mohtheghost/cardboard-robot-voice-assistant/archive/README.md

# Archived firmware versions

Every prototype `.ino` from the development folder, unchanged except that the WiFi name,
WiFi password and server IP were replaced by placeholders. File names are the original
download names: a `_N` suffix is a browser "download again" copy, **not** a version number.
Order them by the date column. `docs/history.md` tells the story; this is the index.

Status meanings: **milestone** = worth reading, **intermediate** = a step on the way,
**broken** = does not compile or is not code, **duplicate** = identical to another file,
**test** = a hardware test utility.

## First mic + speaker attempts (Feb 20-22)

| Date | File | Rate | JSON | Status | What changed |
|---|---|---|---|---|---|
| 2026-02-20 22:10 | `esp32_full_duplex.ino` | 8 kHz | ArduinoJson | intermediate | Origin of the family (no earlier file). Establishes the send path (register {"id":"esp32"} l133, {"target":"pc","type":"audio"} l352), the ArduinoJson StaticJsonDocument<512> parse of incoming tts chunks (l157-174), and the buffer-then-play TtsPlayback struct (l76-86). |
| 2026-02-20 22:34 | `esp32_dual_i2s_final.ino` | 8 kHz | ArduinoJson | intermediate | vs esp32_full_duplex.ino: splits the single duplex port into i2s_install_microphone() (l91, I2S_NUM_0, MASTER\|RX, use_apll true) and i2s_install_speaker() (l116, I2S_NUM_1, MASTER\|TX, 16-bit, use_apll false) with the 14/12/13 amplifier pins; playTtsAudio drops the pcm32 malloc and <<14 loop and writes tts.buffer as int16 to I2S_SPK_PORT; the mic-pause-during-TTS block in loop() (old l477-482) is removed; comments and banners trimmed. |
| 2026-02-21 03:17 | `esp32_dual_i2s_final_1.ino` | 8 kHz | ArduinoJson | intermediate | vs esp32_dual_i2s_final.ino (65 changed lines): purely diagnostic additions to find out why no TTS was being received: DEBUG_MODE (l27), messagesReceived (l92), first-100-chars dump of each WStype_TEXT (l166-172), parse-error reason (l193-197), explicit 'No type field' / 'Unknown type' branches (l206-220), containsKey checks (l226-237). No audio-path change. |
| 2026-02-21 14:16 | `esp32_simple_clean.ino` | 8 kHz | ArduinoJson | broken | vs esp32_dual_i2s_final_1.ino (chronologically previous; 712-line delta, a rewrite not a patch): drops the DEBUG_MODE tracing, the static B64/json buffers, the TtsPlayback struct and printStats(); replaces them with flat globals and a 24 KB pair of stack-local arrays in sendTask (l316/l323) that cannot fit the 8192-byte task stack (l378). Behaviourally still buffer-all-then-play with a 300KB malloc (l134). |
| 2026-02-21 14:53 | `esp32_dual_i2s_final_2.ino` | 8 kHz | ArduinoJson | intermediate | Derived from esp32_dual_i2s_final_1.ino, not from the chronologically previous esp32_simple_clean.ino (31 changed lines vs _1, 729 vs simple_clean). Memory fixes for the failing 300KB TTS malloc: queue halved (l49), buffer halved (l53), heap-aware allocation with '[TTS] Reducing buffer' path (l269-281), heap stats at boot (l520-521), and the mic pause during TTS restored (l537-541). |
| 2026-02-21 15:04 | `esp32_dual_i2s_final_3.ino` | 8 kHz | ArduinoJson | **milestone** | vs esp32_dual_i2s_final_2.ino (32 changed lines): .use_apll true->false on the microphone config (l105) to stop an I2S MCLK error; allocation now uses the largest contiguous block (ESP.getMaxAllocHeap, l270) instead of total free heap, with a hard abort below 30KB (l274-278) and bufferSize = largestBlock-30KB (l280); failure message reworded (l290-291); capacity-in-seconds log (l297-298). |
| 2026-02-21 16:57 | `esp32_ultra_optimized.ino` | 8 kHz | ArduinoJson | **milestone** | vs esp32_dual_i2s_final_3.ino (653-line delta, rewrite): abandons the large TTS buffer entirely; the anonymous tts struct (l62-70) holds a single 8KB playBuffer, handleTtsChunk (l150-226) decodes each chunk into it, sets tts.playing and waits until streamingPlayTask (l134-147) has written it; the DEBUG_MODE tracing, TtsPlayback struct, printStats and static B64 buffers are removed; queue and batch sizes cut (l43-44); mic gated in both sendTask (l300) and loop (l362). |
| 2026-02-21 17:50 | `esp32_test_then_tts.ino` | 8 kHz | ArduinoJson | intermediate | vs esp32_ultra_optimized.ino (201 changed lines): adds testSpeaker() (l68-110) and calls it before networking (l402) to confirm the amplifier wiring; adds a bounded wait with 'Playback timeout!' (l239-247); adds diagnostic prints around every incoming message (l273-274, l278-297); delay(500)->delay(1000) at boot; the audio path itself is unchanged. |
| 2026-02-21 22:59 | `esp32_voice_assistant_simple_base.ino` | 8 kHz | ArduinoJson | intermediate | vs esp32_test_then_tts.ino (chronologically previous; 423-line delta) and really a merge of esp32_ultra_optimized.ino (340-line delta) with the simple_receiver code: testSpeaker and the tts struct are gone; handleTtsChunk/streamingPlayTask become handleAudio/playbackTask with plain globals (l65-68); the play task is spawned in setup (l340); heartbeat dropped; 'registered' renamed 'connected'; setup reordered so both I2S ports come up before WiFi. |
| 2026-02-22 01:33 | `esp32_voice_assistant_FIXED.ino` | 8 kHz | ArduinoJson | **milestone** | vs esp32_voice_assistant_simple_base.ino (34 changed lines): `bool playing` -> `volatile bool playing` (l68), plus logging only: micChunksSent (l72, l289, l306-308), play start/complete prints (l138, l148), mic-active banner (l244-247), heap print (l369), banner text change (l323). No other logic change. |

## Isolated tests and merges (Feb 21-22)

| Date | File | Rate | JSON | Status | What changed |
|---|---|---|---|---|---|
| 2026-02-21 16:03 | `esp32_speaker_test.ino` | 8 kHz | - | test | First file of the family; nothing before it. Its i2s_config_t block (lines 23-35) is copied verbatim into every later speaker setup in the family. |
| 2026-02-21 21:18 | `esp32_simple_receiver.ino` | 8 kHz | ArduinoJson | **milestone** | Adds WiFi/WebSocketsClient/ArduinoJson/mbedtls includes (lines 14-18) around the speaker_test I2S config (lines 48-60 identical to speaker_test 23-35); adds playbackTask (77-90), handleAudio (93-151), onMessage (154-169), webSocketEvent with registration (171-191) and setReconnectInterval(3000) (220). |
| 2026-02-21 21:51 | `esp32_simple_receiver_fixed.ino` | 8 kHz | ArduinoJson | intermediate | vs esp32_simple_receiver.ino: removes the post-trigger while(playing) loop (old 141-146), adds a bounded wait only on chunk 0 (125-131), adds heartbeat (256), WiFi.setSleep(false) (233), PING/PONG handlers (209-216), status printout (275-287), beep counters (52-53, 120-123), and zero_dma after each i2s_write (94). Registration moves to line 200. |
| 2026-02-21 22:17 | `esp32_hybrid_perfect.ino` | 8 kHz | ArduinoJson | intermediate | vs esp32_simple_receiver_fixed.ino: code-only diff is small: drops lastBeepTime and the per-write i2s_zero_dma_buffer, raises the chunk-0 wait timeout 100->200 and inserts webSocket.loop() in it (118-119), re-adds a post-trigger wait loop that also calls webSocket.loop() (156-161), restores zero_dma after the last chunk (166), removes WStype_PING/PONG cases. |
| 2026-02-22 01:45 | `esp32_exact_combination.ino` | 8 kHz | ArduinoJson | intermediate | vs esp32_hybrid_perfect.ino: not derived from it; it reverts to the simple_receiver speaker code (plain while(playing) vTaskDelay wait at 199-201, no heartbeat, no setSleep) and adds the whole mic side: pins 26-28, queue/AudioChunk 44-62, setupMicrophone 104-131, sendAudioChunk 252-273, sendTask 275-299, xQueueCreate 335, second task 343, mic read/convert/enqueue in loop 371-400. |
| 2026-02-22 02:08 | `esp32_simple_mic_test.ino` | 8 kHz | - | **milestone** | vs esp32_exact_combination.ino: strips it to the mic half only: no speaker, no ArduinoJson, no queue/sendTask/malloc; the conversion and batching move inline into loop() (192-216) using a stack int16_t samples[512] (195); adds an explicit I2S read-error print (181-185). |
| 2026-02-22 02:20 | `esp32_perfect_voice_assistant.ino` | 8 kHz | ArduinoJson | intermediate | vs esp32_simple_mic_test.ino: adds back ArduinoJson and the entire simple_receiver speaker side (pins 32-34, BUFFER_SIZE 45, globals 50-54, setupSpeaker 66-93, playbackTask 126-139, handleAudio 142-200, onMessage 230-245, WStype_TEXT case 264, task create 308); makes playing volatile (53); inserts the if(playing){delay;return;} mic pause (329-333). Vs exact_combination it drops the queue, sendTask, DMA_BUF_* and SEND_QUEUE_SIZE defines and renames I2S_MIC_* to MIC_*. |
| 2026-02-22 02:40 | `esp32_debug_version.ino` | 8 kHz | ArduinoJson | test | vs esp32_literal_combination.ino (47 s later): code-only diff adds messagesReceived, the two esp_err_t captures, DeserializationError handling, waitCount, PING/PONG/ERROR cases, lastPausePrint and errorCount statics; no change to audio logic, buffer sizes or the (non-volatile) playing flag. |
| 2026-02-22 02:40 | `esp32_literal_combination.ino` | 8 kHz | ArduinoJson | near-duplicate of `esp32_perfect_voice_assistant.ino` | vs esp32_perfect_voice_assistant.ino: with comments, blank lines and Serial prints stripped the only code difference is line 53 'volatile bool playing' -> line 50 'bool playing'; everything else is header/banner/comment text and four removed Serial.println calls (old 258-261) plus the free-heap print (old 317). |
| 2026-02-22 02:48 | `esp32_minimal_merge.ino` | 8 kHz | ArduinoJson | intermediate | vs esp32_debug_version.ino: removes all debug prints and the PING/PONG/ERROR cases; speaker side is now byte-for-byte the simple_receiver logic (diff vs simple_receiver is only comments, the base64_decode call folded onto two lines 117-118, and the added mic code 46-53, 138-187, 230, 261-287); the if(playing) mic-pause block present in every merge since exact_combination is deleted. |

## "Production" firmware, morning session (Feb 22)

| Date | File | Rate | JSON | Status | What changed |
|---|---|---|---|---|---|
| 2026-02-22 02:57 | `esp32_production_voice_assistant.ino` | 8 kHz | ArduinoJson | intermediate | First file of the family; no predecessor in this family. |
| 2026-02-22 06:12 | `esp32_production_voice_assistant_1.ino` | 8 kHz | ArduinoJson | broken | Adds `.mck_io_num = I2S_PIN_NO_CHANGE` after `.data_in_num` in the mic pinConfig (line 311) and speaker pinConfig (line 386); swaps setup() so the microphone is initialised first (lines 905-914). Because mck_io_num is the first member of i2s_pin_config_t in IDF 4.4, placing its designator last violates g++'s declaration-order rule for designated initializers, so this revision almost certainly failed to compile (the next file's comment confirms 'field order issues'). |
| 2026-02-22 06:15 | `esp32_production_voice_assistant_2.ino` | 8 kHz | ArduinoJson | intermediate | Removes the trailing `.mck_io_num` designators from both initializer lists and instead assigns `pinConfig.mck_io_num = I2S_PIN_NO_CHANGE;` after the struct is built (lines 313-315 and 389-391), with the comment 'AFTER struct creation to avoid field order issues'. This is the first compiling version with the MCLK fix; no other changes. |
| 2026-02-22 06:24 | `esp32_production_voice_assistant_3.ino` | 8 kHz | ArduinoJson | **milestone** | Adds `SPK_VOLUME_GAIN 5.0f` at line 82 (comment 'was 3.0f' implies an unsaved 3.0 intermediate) and a software gain+clamp loop over speaker.audioBuffer in speakerPlaybackTaskFunction (lines 684-699); the 'Playing' debug line now prints the gain. Nothing else changed. |
| 2026-02-22 06:42 | `esp32_production_voice_assistant_4.ino` | 8 kHz | ArduinoJson | duplicate of `esp32_production_voice_assistant_3.ino` | No changes: md5 350457be2dd1553e242d1afa6ab7e388 is identical to _3 (diff output is empty even before CR stripping). A Chrome 'download again' copy saved 18 minutes later. |
| 2026-02-22 15:50 | `esp32_production_voice_assistant_5.ino` | 8 kHz | ArduinoJson | intermediate | Replaces play-per-chunk with accumulate-then-play: buffer allocation changes from SPK_PLAYBACK_CHUNK_SIZE to `estimatedSize = totalChunks * 2048` capped at 150 KB (lines 576-580); decode target becomes `speaker.audioBuffer + speaker.bufferUsed` with remaining-space limit (lines 610-611); `speaker.bufferUsed += decodedLength` (line 625); the isPlaying/wait block moves inside the last-chunk branch (lines 638-663) with timeout `durationSec*1000 + 2000` instead of 5000 ms. Intended to remove inter-chunk gaps; costs up to 150 KB heap and blocks the WS callback for the entire utterance. |
| 2026-02-22 15:59 | `esp32_production_voice_assistant_6.ino` | 8 kHz | ArduinoJson | intermediate | Adds three defensive checks to handleTtsAudioChunk: force chunkNumber=0 when audioBuffer is null (lines 561-565), reset on out-of-order chunk (lines 567-578), and a pre-decode 'Buffer full' check using (base64Length*3)/4+4 (lines 627-638). Sets `speaker.currentChunk = -1` at allocation (line 612) and after the last chunk (line 715), makes the 'buffer allocated' log unconditional and prints free heap on failure (lines 620-622). Accumulate strategy unchanged. |
| 2026-02-22 16:07 | `esp32_production_voice_assistant_7.ino` | 8 kHz | ArduinoJson | **milestone** | Reverts accumulate mode: deletes the sequence/buffer-full guards (old lines 561-578, 628-638), replaces the totalChunks*2048 allocation with a fixed 8192-byte CHUNK_BUFFER_SIZE (line 562), decodes at `speaker.audioBuffer` with `speaker.bufferUsed = decodedLength` (lines 604-605, 616), moves the isPlaying/wait block back to per-chunk with a 2 s timeout (lines 628-639), keeps `currentChunk = -1` sentinel in the reinit condition (line 565) and cleanup (line 662), changes progress logging to every 10 chunks (line 621), and reduces MIC_SEND_QUEUE_SIZE 32->16 'to save RAM for TTS' (line 95). Net effect: back to the base/_3 per-chunk design with less RAM pressure. |

## "Production" firmware, evening session (Feb 22-23)

| Date | File | Rate | JSON | Status | What changed |
|---|---|---|---|---|---|
| 2026-02-22 16:28 | `esp32_production_voice_assistant_8.ino` | 8 kHz | ArduinoJson | intermediate | Baseline of this sub-family (the _1.._7 copies belong to another owner and were not diffed here). Distinguishing values: SPK_VOLUME_GAIN 5.0f (L82), WS_HEARTBEAT 15000/3000/2 (L51-53), 2000 ms blocking wait per TTS chunk inside the WS callback (L656) with no webSocket.loop() calls during the wait - the combination that makes the connection drop mid-TTS and motivates _9. |
| 2026-02-22 16:50 | `esp32_production_voice_assistant_9.ino` | 8 kHz | ArduinoJson | intermediate | vs _8: adds brownout-detector switch and includes (L31-32, L49, L1124-1132); heartbeat 15000/3000/2 -> 5000/10000/5 (L58-60); speaker gain 5.0 -> 2.0 (L89); the 2000 ms wait loop now calls webSocket.loop() every 5 ms instead of vTaskDelay(10) (L681-685) and a 200 ms keep-alive loop is added after the final chunk (L704-709); loop() gains two extra webSocket.loop() calls (L1310, L1317); declares SpeakerChunk/SPK_CHUNK_QUEUE_SIZE that nothing uses. |
| 2026-02-22 16:57 | `esp32_production_voice_assistant_10.ino` | 8 kHz | ArduinoJson | intermediate | vs _9: only speakerPlaybackTaskFunction and the diagnostics dashboard change - unconditional (not DEBUG_SPEAKER-gated) logging of buffer address, sample values before/after gain, non-zero count, per-2048-byte write progress and completion timestamps (L732-823), plus a Playback Task health row (L1037-1038). No behavioural change; a 'is the speaker actually getting non-zero audio' diagnostic build. |
| 2026-02-22 19:38 | `esp32_production_voice_assistant_11.ino` | 8 kHz | ArduinoJson | broken | vs _10: adds the isBuffering gate and 'Buffering first 3 chunks' messages (L630, L678-690, L726-727); replaces the 2000 ms wait with a 30 ms shortWait (L702-712) and adds timeout/completion logs (L717-720); speaker task gains duration calculation (L850-856) and a 30 ms keep-alive loop (L857-865). Introduces the duplicate `size_t sampleCount = totalWritten / 2;` at L852, a redeclaration of L773 in the same scope -> compile error. |
| 2026-02-22 19:45 | `esp32_production_voice_assistant_12.ino` | 8 kHz | ArduinoJson | intermediate | vs _11: single-line diff - deletes _11 L852 (`size_t sampleCount = totalWritten / 2;`) so expectedDurationMs at L852 now uses the sampleCount from L773 (bufferUsed/2, same value when the whole buffer is written). This is the compile fix for _11, made 7 minutes later; near-duplicate of _11 by content but the only buildable one of the pair. |
| 2026-02-22 20:04 | `esp32_production_voice_assistant_13.ino` | 8 kHz | ArduinoJson | intermediate | vs _12: removes isBuffering and its messages (reverts L630, L678-690, L726-727 to 'PLAY THIS CHUNK IMMEDIATELY' L677-678); timeout becomes expectedDurationMs + 1000 (L683) and the wait loop uses it (L691); speaker task's 30 ms loop becomes a wait for the full expectedDurationMs (L835-843) with 'Waited N ms, audio finished' log (L844-845). Motivation: the 30 ms pacing let the main thread overwrite the single buffer before it was played. |
| 2026-02-22 20:13 | `esp32_production_voice_assistant_14.ino` | 8 kHz | ArduinoJson | **milestone** | vs _13: handleTtsAudioChunk wait becomes a fixed 200 ms 'buffer copied to DMA' wait (L681-698, timeout variable L684) with new log text (L692-698); speakerPlaybackTaskFunction drops the expectedDurationMs wait loop and 'Waiting for audio to finish' (removed _13 L835-843), keeps the duration calculation for logging only (L827-830) and logs 'Chunk written to I2S DMA buffer' (L832-834). |
| 2026-02-23 00:35 | `esp32_production_voice_assistant_15.ino` | 8 kHz | ArduinoJson | test | vs _14: adds the two noise defines (L111-114), the noise-buffer allocation and banner at task start (L742-761), PRIORITY 1/2 comments (L763), 'Background noise PAUSED for TTS' (L767) and 'will resume' (L861) logs, lastNoiseTime = millis()+2000 after TTS (L867-870) and the else-branch that streams the noise buffer with a 10-tick i2s_write timeout (L871-890). No change to the TTS or mic paths. |

## Production variants: MCLK fix, diagnostics, LED (Feb 23-24)

| Date | File | Rate | JSON | Status | What changed |
|---|---|---|---|---|---|
| 2026-02-23 14:22 | `esp32_voice_assistant_FIXED_1.ino` | 8 kHz | ArduinoJson | intermediate | Earliest file in the family. Despite the name it is not a re-download of esp32_voice_assistant_FIXED.ino (Feb 22, 11,420 B) but a different 63 KB program; the _1 suffix is a download-name collision. Known defect: handleTtsAudioChunk allocates speaker.audioBuffer only when chunkNumber == 0 (563) and bails with 'Audio buffer not initialized' at 596-598 for any other first chunk. |
| 2026-02-23 15:39 | `esp32_voice_assistant_FIXED_2.ino` | 8 kHz | ArduinoJson | intermediate | Only handleTtsAudioChunk changed (FIXED_1 lines 562-598 -> 562-588): allocation trigger becomes 'if (speaker.audioBuffer == nullptr)' with comment 'FIX: Initialize buffer when NULL, not just on chunk 0!', speaker.currentChunk initialised to -1 (582), the free-previous-buffer block and the 'Audio buffer not initialized' early return are removed. Fixes silent playback when the first TTS chunk that arrives is not chunk 0. |
| 2026-02-23 16:10 | `esp32_voice_assistant_FIXED_3.ino` | 8 kHz | ArduinoJson | intermediate | speakerPlaybackTaskFunction only (671-775): replaces the DEBUG_SPEAKER-gated 'Playing/Played' prints with always-on sample dumps and statistics, adds 'break' when i2s_write reports bytesWritten == 0 (757-761) and an expected-duration printf (770-772). Debug build to determine whether 'hear nothing' was silent PCM from the PC or a dead I2S output. |
| 2026-02-23 16:49 | `esp32_voice_assistant_FIXED_4.ino` | 8 kHz | ArduinoJson | duplicate of `esp32_voice_assistant_FIXED_3.ino` | No changes: md5 ab1e3988e73e2f87bb126b91386b1cc5 matches FIXED_3 exactly (CR-stripped diff empty). Chrome re-download. |
| 2026-02-23 17:19 | `esp32_voice_assistant_FIXED_5.ino` | 8 kHz | ArduinoJson | **milestone** | Versus FIXED_3/4: reverts all FIXED_3 diagnostic prints (and drops the DEBUG_SPEAKER 'Playing/Played' prints entirely), then tunes for WebSocket stability: heartbeat 15000/3000/2 -> 5000/10000/5 (52-54), all DEBUG_* false (119-122), playback wait vTaskDelay(5) -> delay(1) (629), speaker task loop 10 -> 5 ms (715), loop() delays 10 -> 5 ms (1063, 1069, 1093, 1099, 1115) and the end-of-loop delay(10) removed (1161-1162) so webSocket.loop() is serviced as often as possible. Addresses heartbeat/pong timeouts (disconnects) during TTS playback. |
| 2026-02-23 19:43 | `ESP32_WITH_DIAGNOSTICS_COMPLETE.ino` | 8 kHz | ArduinoJson | intermediate | Not a diff-descendant of FIXED_5: a from-scratch 488-line condensation that adds the remote-diagnostic channel and cuts speaker gain to 0.5 for brownout. Mic path is lossy: pcmBuf (512 samples) is overwritten on every i2s_read and only sent on every 6th read (482-486), so 5/6 of the microphone audio is discarded instead of batched. |
| 2026-02-23 19:53 | `ESP32_PRODUCTION_WITH_DIAGNOSTICS.ino` | 8 kHz | ArduinoJson | **milestone** | Ports the diagnostic channel from ESP32_WITH_DIAGNOSTICS_COMPLETE back onto the full FIXED_5 code base (restoring the proper mic queue/task the 488-line version had dropped). Versus FIXED_5 the diff is: comments removed throughout, sendDiagnostic()/addDiagnostic() added at 184-242 with ~15 call sites, SPK_VOLUME_GAIN 2.0 -> 0.5 (69), header/banner retitled; all audio/WS logic otherwise identical. |
| 2026-02-24 00:39 | `ESP32_WITH_LED_INDICATOR.ino` | - | - | not kept | Not firmware: the download of this file failed and produced a 233-byte error message instead of code, so it is not kept. The LED firmware was regenerated 22 minutes later as `ESP32_COMPLETE_WITH_LED.ino`. |
| 2026-02-24 01:01 | `ESP32_COMPLETE_WITH_LED.ino` | 8 kHz | ArduinoJson | **milestone** | Branches from FIXED_5, not from ESP32_PRODUCTION_WITH_DIAGNOSTICS: the CR-stripped diff against FIXED_5 is purely the LED additions listed above (+78 lines), so it does not carry the diagnostic channel or the 0.5 brownout gain. Minor smell: ledBlink() uses blocking delay() and is invoked from the WS event callback on WStype_ERROR (about 600 ms stall). |

## March rewrite: stable WebSocket, 16 kHz, hand-written JSON parser (Mar 30)

| Date | File | Rate | JSON | Status | What changed |
|---|---|---|---|---|---|
| 2026-02-23 21:05 | `ESP32_ASYNC_TTS_FIXED.ino` | 8 kHz | ArduinoJson | intermediate | First file of the family (five weeks older than the rest); no in-family predecessor. Its async TTS queue design is what ESP32_FIXED_HEARTBEAT.ino replaced wholesale (diff between them touches 1121 lines). |
| 2026-03-30 00:51 | `ESP32_FIXED_HEARTBEAT.ino` | 8 kHz | ArduinoJson | **milestone** | Complete rewrite vs ESP32_ASYNC_TTS_FIXED.ino (1121 diff lines): drops the SystemStats/TtsChunk design, adds LED_PIN 2, wsSendQueue, WiFi reconnect, backpressure instead of dropping, streamId tracking, heartbeat raised to 15 s, SPK gain 0.5->2.0. The heartbeat-disabled predecessor it 'fixes' is not in the folder (no .ino has WS_HEARTBEAT_INTERVAL_MS 0). |
| 2026-03-30 01:08 | `ESP32_16KHZ_HIGH_QUALITY.ino` | 16 kHz | ArduinoJson | intermediate | vs ESP32_FIXED_HEARTBEAT.ino: sample rate 8000->16000 (line 46), MIC gain 2.0->1.5 and SPK gain 2.0->1.5 (lines 52-53), header/banner text now 'HIGH QUALITY AUDIO (16kHz) for clearer Arabic TTS'; the rest is log-string edits and deletion of explanatory comments (old lines 338-339, 376, 396, 404, 610, 624) plus removal of the RSSI print and heartbeat log lines (old 480-481, 548-549, 562-563). No logic change. |
| 2026-03-30 02:37 | `ESP32_16KHZ_HIGH_QUALITY_1.ino` | 16 kHz | ArduinoJson | intermediate | vs ESP32_16KHZ_HIGH_QUALITY.ino: only lines 448-451 change - StaticJsonDocument<512> replaced by DynamicJsonDocument(8192) with the note 'Each chunk can be 4KB PCM -> 5.4KB base64 -> needs ~6KB JSON buffer'. 4-line diff. |
| 2026-03-30 12:35 | `ESP32_WITH_TEST_BEEP.ino` | 16 kHz | hand-written | broken | vs ESP32_16KHZ_HIGH_QUALITY_1.ino: removes #include <ArduinoJson.h>, adds WEBSOCKETS_MAX_DATA_SIZE 24 KB and the ~130-line lite JSON parser (lines 251-382), rewrites handleWebSocketMessage (658-670), adds the test-beep block (57-61, 143-145, 183-249, 644-646, 799-801, 826-834), and shrinks SPK_PLAY_QUEUE_SIZE to 8. First file in the whole folder with the lite parser. |
| 2026-03-30 12:40 | `ESP32_WITH_TEST_BEEP_1.ino` | 16 kHz | hand-written | intermediate | vs ESP32_WITH_TEST_BEEP.ino: single-line diff - line 198 'const float TWO_PI = ...' deleted, which makes the sketch compile against the ESP32 core's TWO_PI macro. Everything else byte-identical (line numbers shift by -1 after 198). |
| 2026-03-30 20:29 | `ESP32_WITH_TEST_BEEP_2.ino` | 16 kHz | hand-written | intermediate | vs ESP32_WITH_TEST_BEEP_1.ino: reorders loop() so the periodic-beep block precedes the wsConnected early-return (old 822-834 -> new 829-841), adds the setup() info lines 800-805, and changes the registration log to 'Test beep running' + 'Beep pauses during TTS playback' (lines 692-694). 8-line functional diff. |
| 2026-03-30 23:40 | `ESP32_WITH_WAKE_BEEP.ino` | 16 kHz | hand-written | **milestone** | vs ESP32_WITH_TEST_BEEP_2.ino: playTestBeep() body extracted into generateBeep(int,int,float) (190-251) with playTestBeep/playWakeWordBeep wrappers (254-264); new WAKE_BEEP_* defines (65-67) and BEEP_VOLUME 0.15->0.05 (62); handleWebSocketMessage gains a wake_beep check before the tts check (673-680); registration log prints both beep configs (714-717); banner text 'WITH WAKE WORD CONFIRMATION BEEP' (751). |

## Streaming / jitter-buffer line and the current design (Mar 31 - Apr 5)

| Date | File | Rate | JSON | Status | What changed |
|---|---|---|---|---|---|
| 2026-03-31 12:47 | `ESP32_BUFFER_THEN_PLAY.ino` | 16 kHz | hand-written | intermediate | First file of the family by mtime. Content-wise it is a fork of the streaming design later seen in ESP32_STREAMING_OPTIMIZED: SpeakerChunk/spkPlayQueue/flushSpeakerQueue/speakerPlaybackTaskFunction are removed and replaced by TtsBufferState (125-134) plus initTtsBuffer/addTtsChunk/playBufferedAudio (569-735); adds PROGRESS_BEEP_* (72-74) and MAX_TTS_BUFFER_SIZE 150KB (107); MIC_BATCH_SIZE 6 (82), SPK_PLAY_QUEUE_SIZE 8, WS_SEND_QUEUE_SIZE 16, DEBUG_WEBSOCKET true (102). Playback runs synchronously inside the WS event callback (handleTtsAudioChunk 738 -> playBufferedAudio 794). |
| 2026-03-31 13:00 | `ESP32_BUFFER_THEN_PLAY_FIXED.ino` | 16 kHz | hand-written | intermediate | vs ESP32_BUFFER_THEN_PLAY: MAX_TTS_BUFFER_SIZE 150KB->80KB (108); DEBUG_WEBSOCKET true->false (103); initTtsBuffer estimate 4096->3072 bytes/chunk with 16KB floor and ESP.getFreeHeap()-40960 cap (577-598); realloc guarded by free-heap check (643-651); removed the every-10KB playback progress print; added [MEM] heap logs (623, 752, 866) and banner text changes. 32 diff hunks, all in the TTS buffer path or log strings. |
| 2026-03-31 13:09 | `ESP32_STREAMING_OPTIMIZED.ino` | 16 kHz | hand-written | intermediate | vs ESP32_BUFFER_THEN_PLAY_FIXED: removes TtsBufferState, MAX_TTS_BUFFER_SIZE, PROGRESS_BEEP_*, initTtsBuffer/addTtsChunk/playBufferedAudio; restores SpeakerChunk struct (112-118), spkPlayQueue (142), g_ttsStreamId (149), flushSpeakerQueue (181-187), handleTtsAudioChunkParsed (551) and speakerPlaybackTaskFunction (615-666) created via xTaskCreatePinnedToCore (817); MIC_BATCH_SIZE 6->3, MIC_SEND_QUEUE_SIZE 32->64, SPK_PLAY_QUEUE_SIZE 8->16, WS_SEND_QUEUE_SIZE 16->32; header now 'STREAMING MODE (Optimized)' with '~4KB' memory claim (line 7, 828). |
| 2026-03-31 14:06 | `ESP32_JITTER_BUFFER.ino` | 16 kHz | hand-written | intermediate | vs ESP32_STREAMING_OPTIMIZED: adds JITTER_BUFFER_SIZE/JITTER_BEEP_ENABLED (73-74), three volatile fields on SpeakerState (115-117) and their initializer (149-154), playJitterBufferReadyBeep (269-274), pre-buffer bookkeeping in handleTtsAudioChunkParsed (565-570, 623-650), a wait-while-buffering loop plus every-20-chunk playback progress in speakerPlaybackTaskFunction (666-671, 699-707), SPK_PLAY_QUEUE_SIZE 16->20 (87), beep guard at 919; strips the explanatory comments from generateBeep and the BEEP_*/WAKE_BEEP_* defines. |
| 2026-03-31 17:16 | `ESP32_ADAPTIVE_JITTER_BUFFER.ino` | 8 kHz | hand-written | intermediate | vs ESP32_JITTER_BUFFER: AUDIO_SAMPLE_RATE 16000->8000 (54) with matching '8kHz' log strings (413, 446, 451, 484, 806); JITTER_BUFFER_SIZE replaced by INITIAL/LOW/RESUME thresholds (73-75); SPK_PLAY_QUEUE_SIZE 20->30 (89); adds needsRebuffer/rebufferCount (120-121, 157-159); inserts the rebuffer wait loop (672-707) which again calls webSocket.loop() from the SpkPlay task; drops lastPlayedChunk; removes the [BEEP] banner prints (old 773-779, 890-896); loop() beep guard adds !speaker.needsRebuffer (945). |
| 2026-03-31 17:35 | `ESP32_STREAMING_8KHZ.ino` | 8 kHz | hand-written | intermediate | vs ESP32_ADAPTIVE_JITTER_BUFFER: deletes all jitter code - JITTER_* defines (72-77), the five extra SpeakerState fields, playJitterBufferReadyBeep, the buffering/rebuffer branches in handleTtsAudioChunkParsed and speakerPlaybackTaskFunction (old 629-651, 666-707, 735-741, 749-755); SPK_PLAY_QUEUE_SIZE 30->16 (82); banner text back to 'STREAMING MODE (8kHz)'. Net effect: it is ESP32_STREAMING_OPTIMIZED with AUDIO_SAMPLE_RATE 8000, generateBeep comments stripped, BEEP info prints removed, and progress modulo 5->10 (verified by direct diff OPTIMIZED->8KHZ). |
| 2026-04-01 14:24 | `ESP32_STREAMING_8KHZ_1.ino` | 8 kHz | hand-written | **milestone** | vs ESP32_STREAMING_8KHZ: adds SPEECH_ENDED_BEEP_* (74-78), volatile bool micEnabled (155), micEnabled=false + log inside playWakeWordBeep (267-268), new playSpeechEndedBeep (271-280), '&& micEnabled' in the mic task condition (548), micEnabled=true after last chunk in the SpkPlay task (674-677), and a second memContains branch for "type":"speech_ended" in handleWebSocketMessage (698-701). Header rewritten to '8kHz Optimized with Teacher Feedback!'. 8 hunks, all additive. |
| 2026-04-05 20:13 | `ESP32_Speaker_Test_Beep.ino` | 8 kHz | - | test | Not derived from ESP32_STREAMING_8KHZ_1; it is a fresh 168-line sketch that lifts the sine+envelope generator (compare generateBeep in the main firmware) into a loop() that beeps continuously. Only shares the I2S_NUM_1 pin assignment and i2s_config_t block (36-56) with the family. |

## Server

`server-original/Program.cs` is the unified April 7 server exactly as it ran
on the VPS, with the hard-coded OpenAI key replaced by the placeholder
`sk-REPLACE-ME` and an "archived" banner on top. Its comments still say
"8 kHz" although it runs at 16 kHz. The maintained server is `../server`; it
reads your own key from the `OPENAI_API_KEY` environment variable.
