mohtheghost/cardboard-robot-voice-assistant/experiments/whisper-test/README.md

# whisper-test (February 2026)

The very first experiment of the project, one week before the server existed: a
68-line console program that posts a WAV file to OpenAI Whisper and prints the
transcription. The `TranscribeAsync` method in the server is a near-verbatim copy
of it. It already used the `OPENAI_API_KEY` environment variable.

The project was created with Visual Studio's default name "7" (the project file was renamed to `whisper-test.csproj`; the namespace inside is still `_7`).
The `.csproj` references the `OpenAI` and `Newtonsoft.Json` packages from an
earlier text-to-speech test whose code did not survive; the current code uses
neither.

To run it: set `OPENAI_API_KEY` to your own key, then

```bash
dotnet run -- path/to/recording.wav
```

(16 kHz mono WAV works best; without an argument it looks for `audio.wav` in the
current folder). It is kept only as a record of where the project started; the
real code is in `../../server`.
