mohtheghost/cardboard-robot-voice-assistant/(commit log)

2026-09-16 Organise the cardboard robot voice assistant for publication
    Turn a flat folder of 61 prototype .ino files into a structured project:
    - firmware/esp32_voice_assistant: the firmware running on the robot,
    unchanged except that WiFi/server credentials moved to a git-ignored
    secrets.h (secrets.h.example provided)
    - firmware/hardware_tests: speaker beep test and microphone stream test
    - firmware/experimental: the same firmware with review fixes (auth token,
    mic un-mute safety net, no re-entrant webSocket.loop, cleaner end of
    answer); not yet tested on hardware
    - server: OpenAI key read from OPENAI_API_KEY instead of a constant;
    env-var config, send lock, beep ignore window, recording c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
    [ESP32_16KHZ_HIGH_QUALITY.ino, ESP32_16KHZ_HIGH_QUALITY_1.ino, ESP32_ADAPTIVE_JITTER_BUFFER.ino, ESP32_ASYNC_TTS_FIXED.ino, ESP32_BUFFER_THEN_PLAY.ino, ESP32_BUFFER_THEN_PLAY_FIXED.ino, ESP32_COMPLETE_WITH_LED.ino, ESP32_FIXED_HEARTBEAT.ino]
2026-09-16 Final publish pass: demo media, own-key guidance, personal path removed
    - .gitignore: anchor the media rule to the repo root so docs/media (demo GIF
    and clip referenced by the README) is tracked again
    - experiments/whisper-test: WAV path comes from the command line instead of a
    hard-coded personal absolute path; clearer OPENAI_API_KEY message
    - server: reject the sk-REPLACE-ME placeholder at startup, explain OpenAI
    401/429 errors, say the key must be the user's own; README and systemd unit
    say where to create a key and that usage is billed to the user's account
    - firmware docs: main firmware does not send the auth token (leave it empty),
    real boot log of the main firmware, compile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
    [esp32_voice_assistant.ino, esp32_voice_assistant_next.ino]
2026-09-16 Server: ROBOT_BIND option and a clear message when the port cannot be opened
    Default behaviour is unchanged (bind all interfaces). ROBOT_BIND=localhost
    allows a local test on Windows without the admin URL reservation; if the
    reservation is missing the server now prints the netsh command instead of
    an unhandled exception.
    Smoke-tested with a simulated robot against the built server: registration
    with token, VAD calibration, speech start/end, speech_ended message, Whisper
    failure with a dummy key handled without crashing, wrong token rejected,
    oversized message rejected, old connection replaced on reconnect.
2026-09-16 Use 8 kHz audio on both sides; state that a real-key retest is still needed
    8 kHz is the configuration that streamed without stutter on a mobile hotspot
    during development. Firmware AUDIO_SAMPLE_RATE (main, experimental, mic test)
    and the server default are 8000; the server rate is now configurable with
    ROBOT_SAMPLE_RATE. Docs, protocol timings and the history updated to match.
    README and the release notes now state that the server was smoke-tested with
    a simulated robot but the OpenAI calls and the full chain have not been
    re-tested with a real API key on the robot since the refactor.
    Verified: all sketches compile (esp32 core 3.3.7), the server builds with zero
    warnings, and the simulate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
2026-09-16 Tidy names: descriptive photo file names, whisper-test project file
    - docs/images: robot-front.jpg, chest-inside.jpg, mic-inside-arm.jpg ...
    instead of phone camera-roll numbers; all references updated
    - experiments/whisper-test: 7.csproj renamed to whisper-test.csproj, the
    unnecessary solution file removed (still builds)
    - README: archived firmware count is 60
2026-09-16 Add BUILD_GUIDE.md, a step-by-step recipe for first-time builders
    Written for someone who has never used an ESP32, PowerShell or .NET, then
    reviewed from three perspectives (Windows beginner, Linux/VPS user, hardware
    accuracy) and corrected: the 30-pin board's two GND pins vs three ground
    connections, Windows port permission + firewall rule before the first run,
    creating secrets.h in the Arduino IDE, board/port selection, expected output
    and error texts, wake-word behaviour, tuning table with exact lines, hotspot
    catches, and a much longer troubleshooting table.
    Also fixed on the way:
    - server/README.md: a VPS recipe that actually works (service user, /opt
    ownership, root-only /etc/robot-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
